dsorokin15/-/Схема/Screenshot_3.jpg

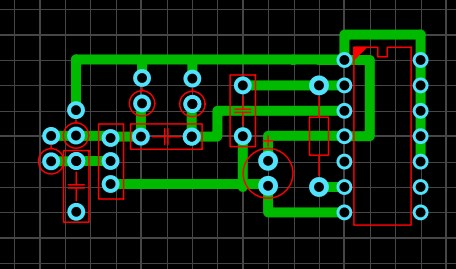
Схема/Screenshot_3.jpg
