dsorokin15/-/Схема/s43343011.jpg

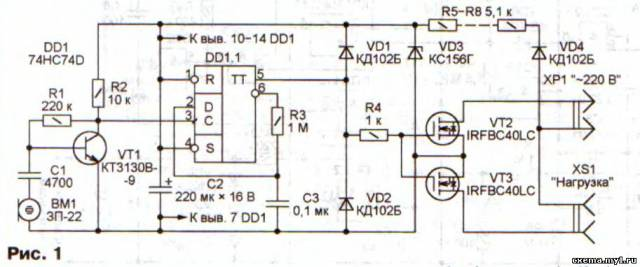
Схема/s43343011.jpg
