dsorokin15/-/КурсоваяСорокинДК51.docx

НАЦІОНАЛЬНИЙ ТЕХНІЧНИЙ УНІВЕРСИТЕТ УКРАЇНИ

«КИЇВСЬКИЙ ПОЛІТЕХНІЧНИЙ ІНСТИТУТ ІМЕНІ ІГОРЯ СІКОРСЬКОГО»

Кафедра конструювання електронно-обчислювальної апаратури

КУРСОВА РОБОТА

з дисципліни Схемотехніка аналогової та цифрової радіоелектронної апаратури

на тему:Акустичний перемикач (АП)

Студента 2 курсу групи ДК-51

Напряму підготовки: Радіоелектронні апарати

Спеціальності: Радіоелектронні апарати та засоби

Сорокіна Д.А.

Керівник:

____________________________________

(посада, вчене звання, науковий ступінь, прізвище та ініціали)

Національна оцінка: ________________

Кількість балів: ____ Оцінка: ECTS _____

Члени комісії: _____________ ___ст. викл., к.т.н. Короткий Є.В.___

(підпис) (вчене звання, науковий ступінь, прізвище та ініціали)

_____________ _________________________________

(підпис) (вчене звання, науковий ступінь, прізвище та ініціали)

Київ − 2017 рік

ЗМІСТ

Зміст_________________________________________________________ | 2
Вступ_________________________________________________________ | 3
1. Вибір та дослідження принципової схеми АП_____________________ | 4
2. Розрахунок принципової схеми (характеристик) АП________________ | 7
3. Моделювання роботи АП______________________________________ | 11
4. Розробка та дослідження конструкції АП_________________________ | 14
Висновки______________________________________________________ | 20
Список використаних джерел _____________________________________ | 21

ВСТУП

Метою даної курсової роботи є створення акустичного вимикача, який може видавати на виході різний рівень напруги, залежно від акустичного впливу на нього. Даний прилад може бути використаний як вимикач для різноманітних приладів, а також реєстратор звукових імпульсів.

Для вирішення даної задачі для початку було обрано принципову схему [1] та досліджено принцип її роботи. Наступним кроком було проведено розрахунки підсилюючого каскаду зі спільним емітером на біполярному транзисторі. Після цього в програмі ltspice була побудована принципова схема та проведена її симуляція, що дозволило перевірити працездатність АП, а також перевірено правильність теоретичних розрахунків. Кінцевим етапом було зібрано АП на макетній платі, з нього було знято певні дані, що були порівнянні з розрахунками та симуляціею в ltspice.

РОЗДІЛ 1

ВИБІР ТА ДОСЛІДЖЕННЯ ПРИНЦИПОВОЇ СХЕМИ АКУСТИЧНОГО ПЕРЕМИКАЧА

Для основи акустичного вимикача була обрана принципова схема наведена на рис. 1.1

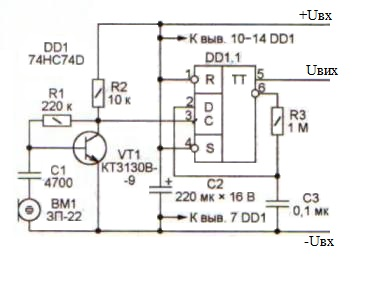
[picture p3: figure]

Рис1.1 Принципова схема акустичного перемикача

В даному випадку наведена спрощена схема, без параметричного стабілізатору напруги [1]. В даній схемі використовується мікросхема 74HC74. Вона містить два незалежних D-тригери, які спрацьовують по фронту тактового сигналу на вході С. Низький рівень напруги (логічний «0») на вході установки (S) чи збросу (R) встановлюють виходи тригера в відповідний стан незалежно від стану інших входів (С та D).

При наявності на вході установки та збросу логічної «1» необхідна попередня установка інформації по виходу даних відносно фронту тактового сигналу, а також відповідна витримка інформації після подачі фронту синхросигналу. Дані істинності наведено в табл. 1.1

Характеристики даної мікросхеми наведені в табл. 1.2. Повний список характеристик можна знайти за посиланням [2].

Таблиця 1.1

Логічна таблиця 74НС74

Входи | | | | Виходи
_ S | _ R | C | D | Q | _ Q
0 | 1 | X | X | 1 | 0
1 | 0 | X | X | 0 | 1
0 | 0 | X | X | Н | Н
1 | 1 | _| | 1 | 1 | 0
1 | 1 | _| | 0 | 0 | 1
1 | 1 | 0 | X | Qo | Qo

Таблиця 1.2

Основні параметри 74НС74

Напруга живлення (Vcc) | +2..6В
Вхідний струм (0/1), не більше | 1мкА
Струм живлення (статичний), max | 20мкА
Вихідний струм лог. "0/1", макс. | 25мА
Тактова частота | до 36МГц
Вихідний рівень "0" | < 0,1В
Вихідний рівень "1" | >Uпит-0,1В
Робочий діапазон температур | -55..+125oC
Корпус 74HC74AN Корпус 74HC74D | DIP-14 SO-14
Вітчизняний аналог | КР/КФ1564ТМ2

Принцип роботи схеми дуже простий. На вході присутній мікрофон, який реєструє зміни звуку у навколишньому середовищі. Він під’єднаний на вхід підсилюючого каскаду на транзисторі, який підсилює реєструючий звук, щоб мікросхема мала змогу його коректно сприймати. Коли на вхід С мікросхеми приходить фронт сигналу, а на вході Д присутня логічна «1», виходи мікросхеми встановлюються відповідно до логічної таблиці Q-«1», а інвертований вихід відповідно «0», який за зворотнім зв’язком подається на вхід Д. Тепер при надходженні наступного фронту на вхід С, на вході Д буде присутній логічний «0», в такому випадку на виході Q встановиться значення логічного «0». В результаті відбувається зміна рівнів напруги «перемикання».

РОЗДІЛ 2

РОЗРАХУНОК ПРИНЦИПОВОЇ СХЕМИ АКУСТИЧНОГО ПЕРЕМИКАЧА

Для попередньої перевірки працездатності схеми було проведено певні розрахунки характеристик, а саме робоча точка підсилюючого каскаду на транзисторі VT1-2N2222A [3] Рис2.1.

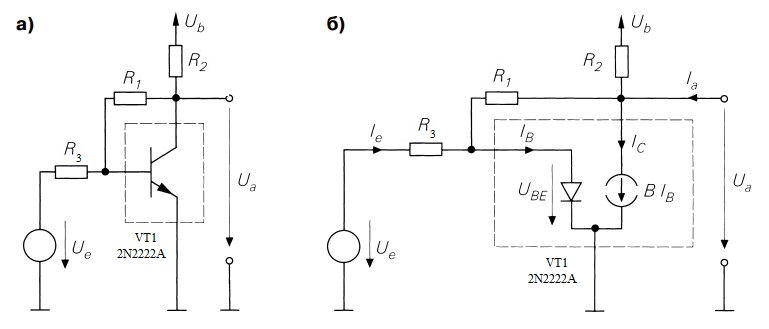
[picture p4: figure]

Рис 2.1 Схема з загальнім емітером і від’ємним зворотним зв’язком за напругою:

а) принципова схема; б) еквівалентна схема для нормального режиму [4]

Розрахунок відштовхувався від обрання напруги коллектор-емітер. Ми вирішили опиратись на значення в 1,3 В, так як це рівень напруги логічного «0» для мікросхеми 74НС74. Тому робоча точка виходу повинна знаходитись трохи нижче (нами обрано значення в 1,2 В) заданного параметру, щоб при надходжені мінімального імпульсу та підсилення D-тригер спрацьовував.

U_(R1) -напруга на резисторі R1

I_(R1) =I_б -струм через резистор R1, дорівнює струму бази

U_(R2) -напруга на резисторі R2

I_(R2) =I_к -струм через резистор R2, дорівнює струму коллектора

U_(ке) - напруга між коллектором та емітером

R1 , R2, R3-резистори номіналом 220кОм/10кОм/0.5кОм відповідно

β -коефіціент відношення струму коллеткора до струму бази

g_m ,S-передаточна провідність

А- коефіціент підсилення за напругою

γ_T -температурние коефіцієнт(26 мВ для кімнатної температури)

За 2 законом Кірхгофа напруга, яка виділиться на R2, буде розраховуватися як:

U_(R2) =U_(живлення) -U_(ке) =5-1.2=3.8 В

За законом Ома можемо знайти струм через цей резистор

I_(R2) =(U_(R2))/(R_2)=3.8/(10*10^3)=0.38 мА

За 1 законом Кірхгофа

I_(R2) = I_б +I_к

Але струм бази достатньо малий для біполярного транзистору, щоб ним можна було знехтувати, тому можна стверджувати, що I_(R2) = I_к

З документації на транзистор для отриманого значення Iк було визначена напруга Uбе, графік залежності Uбе (Iк) наведено на рис 2.1.

Для струму 0.38 А на графіку було знайденне відповідне йому значення напруги Uбе. Для прямої за температури 25⁰С значення Uбе складає 0.63В.

За 2 законом Кірхгофа можемо стверджувати, що

U_(кб) =U_(ке) -U_(бе) =1.2-0.63=0.57 В

Ця напруга буде виділятися на R1, тому за законом Ома ми можемо знайти значення струму Iб

I_б =(U_(кб))/(R_1)=0.57/(2.2*10^5)=2.59 мкА

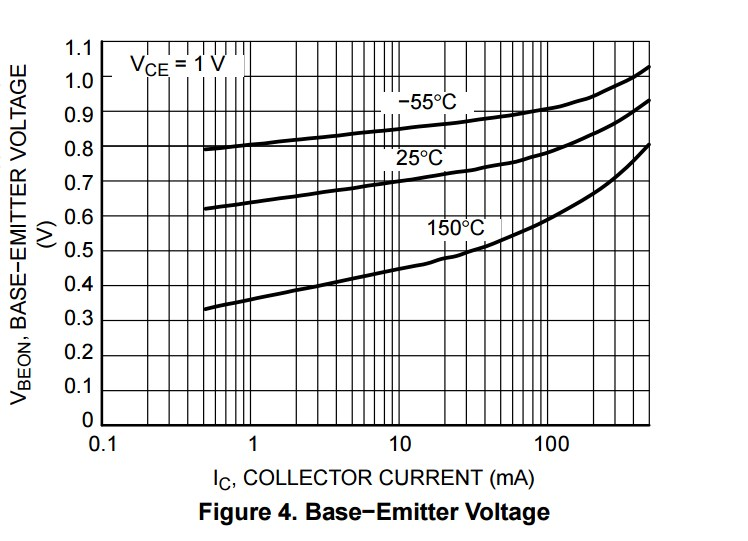
[picture p5: figure]

Рис 2.1. Вихідна характеристика транзистора

Для знайдених значень струму можна розрахувати параметр транзистору β, та передаточну провідність g_m .

β=(І_к)/(І_б)=380/2.59=146,7

g_m =(I_(k0))/(γ_T)=(0,38)/26 =14,61 мСм

Для даної схемі підключення розрахунок коефіцієнту підсилення буде проводитися за формулою (2.1) [3]

A=(-g_m *R_1 +1)/(1+R_3 *(g_m *(1+1/β)+1/(R_c^(')))+(R_1)/(R_c^('))*(1+(R_3)/(r_(be)))) (2.1)

Де

r_(be) =β/(g_m)=(146,7)/(0,01461)≈10 кОм

R_c^(') =(R_2 *r_(ce))/(R_2 +r_(ce))

Вважаючи, що опір переходу коллектор-емітер (rce) буде дуже великим, це випливає з теорії роботи транзистора, можна стверджувати, що опір паралельного з’єднання з R2 буде рівним номіналу R2, а саме 10 кОм.

Тепер можна провести розрахунок

A=(-0,0146*220000+1)/(1+500*(0,0146*(1+1/(146,7))+1/10000)+220000/10000*(1+500/10000))= -54,46

РОЗДІЛ 3

МОДЕЛЮВАННЯ РОБОТИ АКУСТИЧНОГО ПЕРЕМИКАЧА

Для перевірки працездатності принципової схеми було проведено симулювання в програмі LTspice. Для цього було побудовано схему, наведену на рис. 3.1

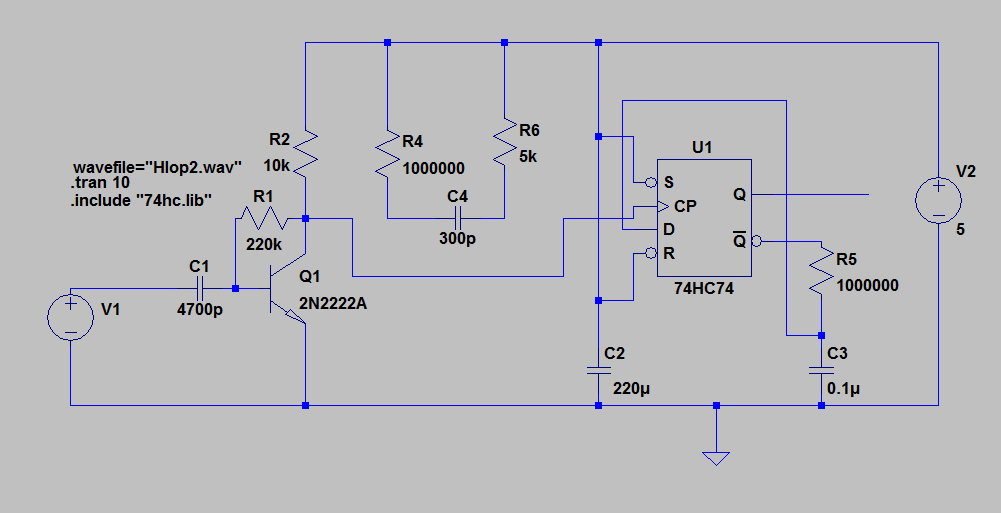
[picture p6: figure]

Рис. 3.1 Схема для симуляції

В даному випадку були внесені певні зміни до конструкції. Практична тестова модель показала, що схема занадто чутлива то зовнішніх збуджувачів, тому було прийняте рішення додати схему для боротьби з дрібяжінням сигналу [5]. Дане рішення суцільно практичне і в симуляції враховане не було. З підключенням цієї схеми симуляція припиняла свою роботу. Це пов'язано с тим, що записаний аудіофайл хлопків сприймався інакше, ніж реальний звук. Результат симуляції наведено на рис 3.2

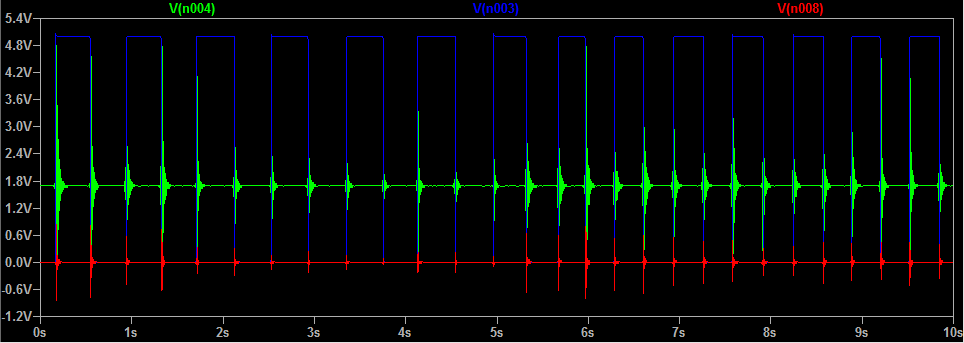
[picture p7: figure]

Рис 3.2 Симуляція роботи спроектованої принципової схеми

На симуляції ми бачимо три графіки:

1. Червоний − напруга, яка подається з джерела. В даному випадку це записаний звук хлопків.
2. Зелений − напруга на колекторі транзистору, який виконує роль підсилюючого каскаду зі спільним емітером.
3. Синій − напруга на виході мікросхеми.

Як бачимо, кожний новій імпульс спочатку підсилюється, щоб сприйматися мікросхемою. Остання в свою чергу реагує на підсилені імпульси та спрацьовує. Як результат на виході мікросхеми відбувається зміна рівнів напруги від 0 В низького рівня (логічний «0») до 5 В високого рівня (логічної «1»). Перевірка розрахованих характеристик. Напруга та струм бази відображено на рис. 3.3

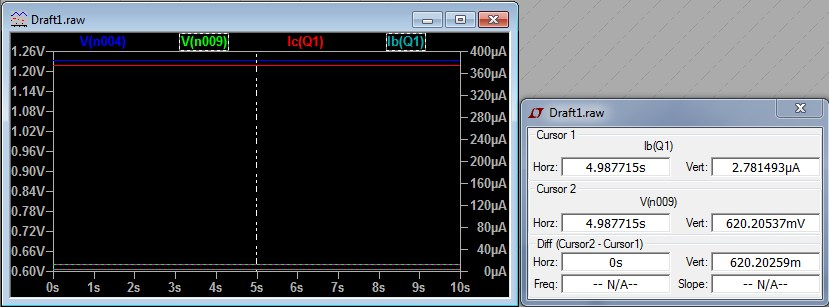
[picture p8: figure]

Рис 3.3 Напруга та струм бази

Напруга та струм колектора показано на рис 3.4

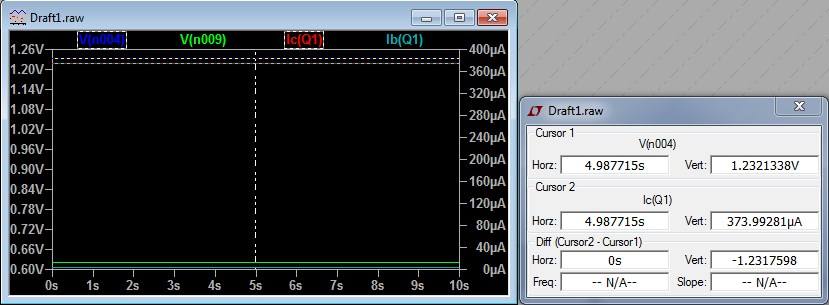
[picture p9: figure]

Рис 3.4 Напруга та струм колектора

Підсилення сигналу показано на рис 3.5

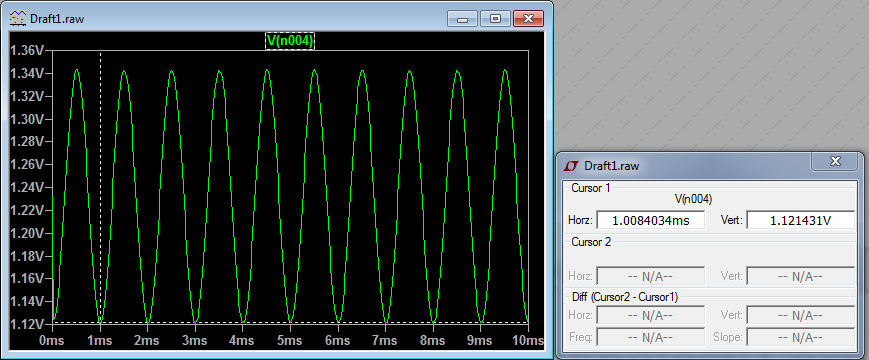
[picture p10: figure]
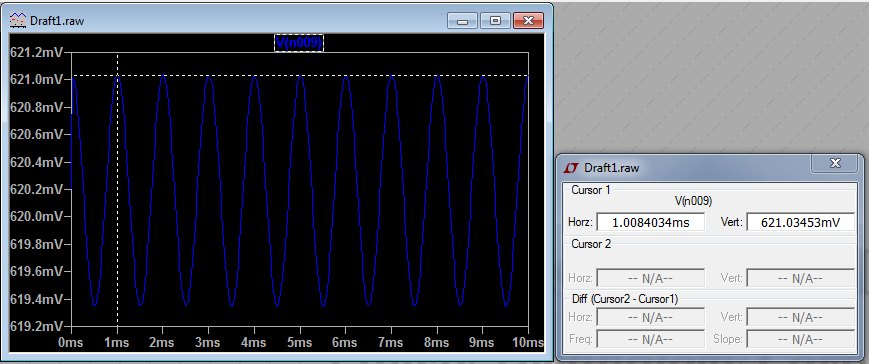
[picture p11: figure]

Рис 3.4 Підсилений сигнал

Коефіціент підсилення за напругою складає 2.

РОЗДІЛ 4

РОЗРОБКА ТА ДОСЛІДЖЕННЯ КОНТРУКЦІЇ АКУСТИЧОГО ПЕРЕМИКАЧА

Щоб упевнития в коректній роботі пристрою спочатку була зібрана тестова модель на макетній платі (див. рис 4.1)

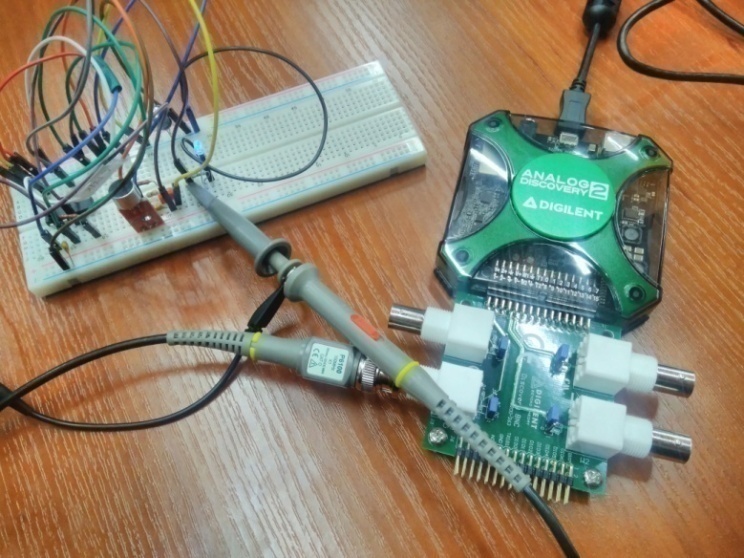
[picture p12: figure]
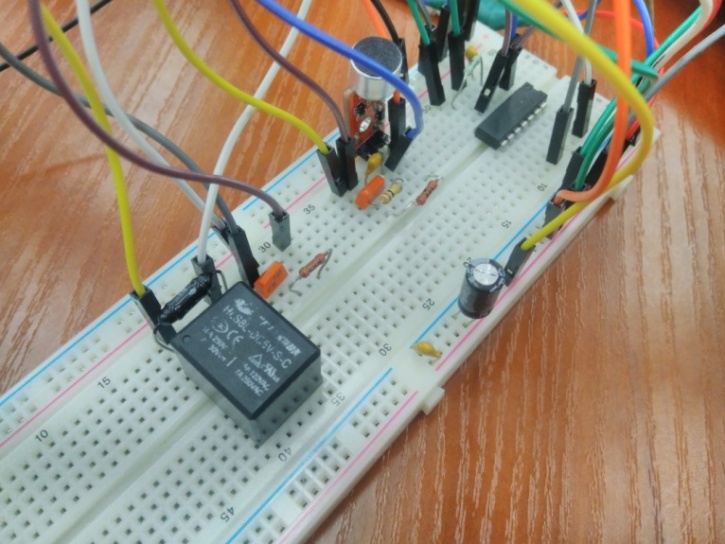
[picture p13: figure]

Рис 4.1 Тестова модель пристрою

Вона показала, що пристрій занадто чутливий. Це було підтверджено за допомогою AnalogDiscovery, знімаючи рівень напруги на вході С D-тригеру (рис 4.2)

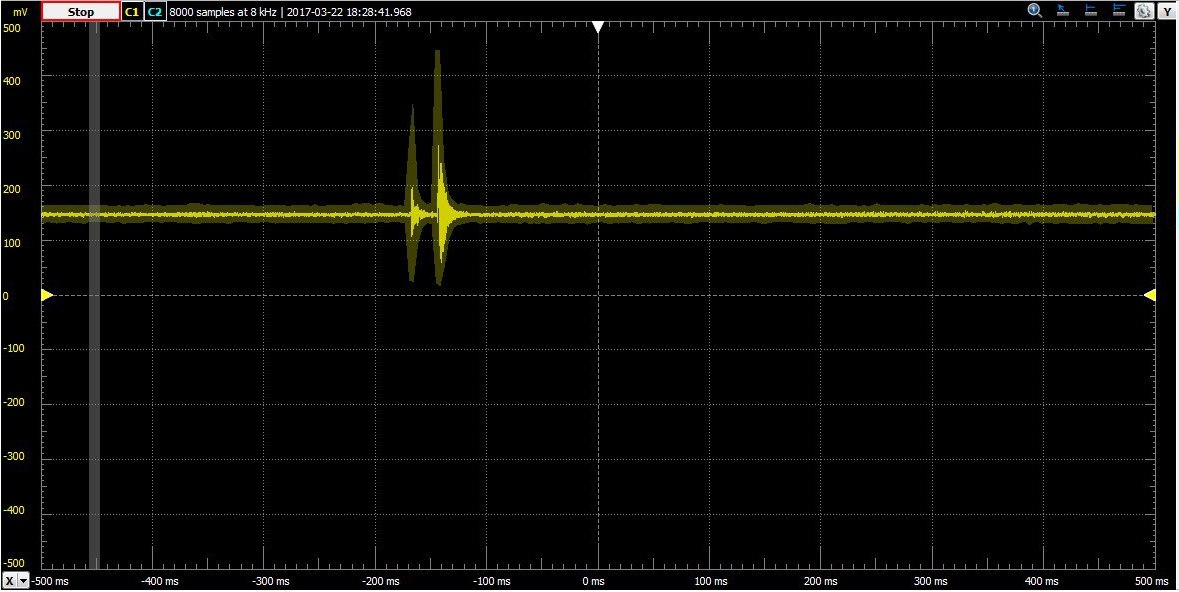
[picture p14: figure]

Рис 4.2 Показники осцилографа з тестовою моделью за допомогою AnalogDiscovery

Так були виялені різкі не однократні перепади сигналу, які призводили до хибних спрацьовувань тригеру. Ця проблема була вирішена за допомогою схеми для боротьби з дріб'яжінням від контактів, яка наведена на рис 4.3.

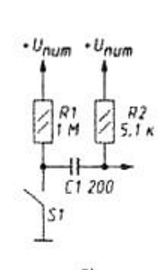
[picture p15: figure]

Рис 4.3 Схема для формування короткого імпульсу

Наступним кроком стало перенесення вже справно працюючого приладу на макетну плату. Для цього у сервісі Sprint Layout було розведено дану схему рис 4.4.


Рис 4.4 Розводка схеми

Після цього на основі побудови було зібрано та спаяно пристрій на макетній платі рис 4.5

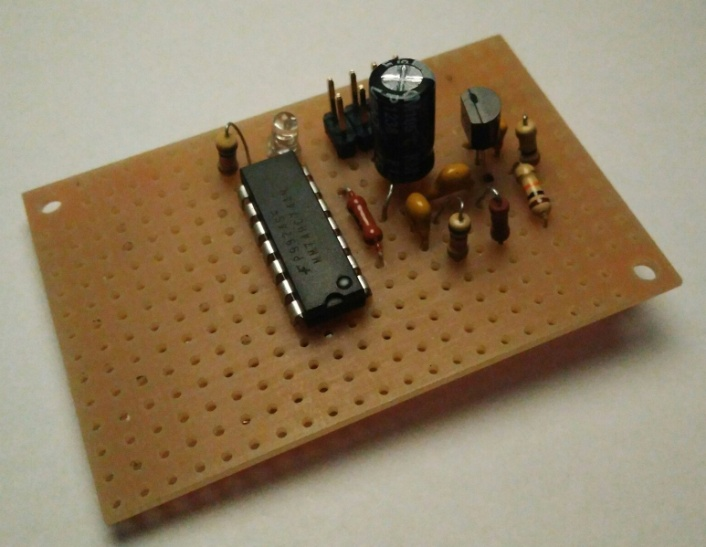
[picture p16: figure]
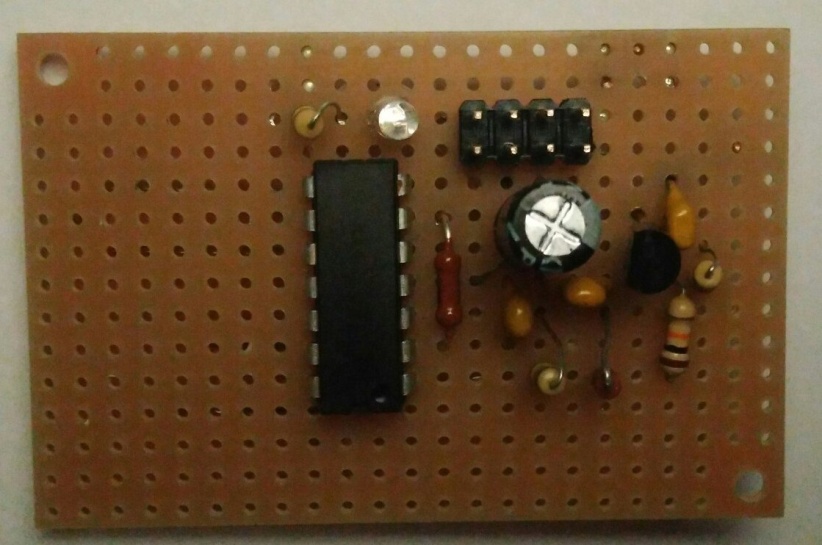
[picture p17: figure]

Рис 4.5 Зібраний прилад на макетній платі

На даному етапі ще не приєднано мікрофон, та було додано світло діод. Це необхідно для зручності проведення подальших тестів з пристроєм. Після необхідних перевірок було додано блок живлення для мережі 220В, та реле, для керування мережею 220В рис 4.6.

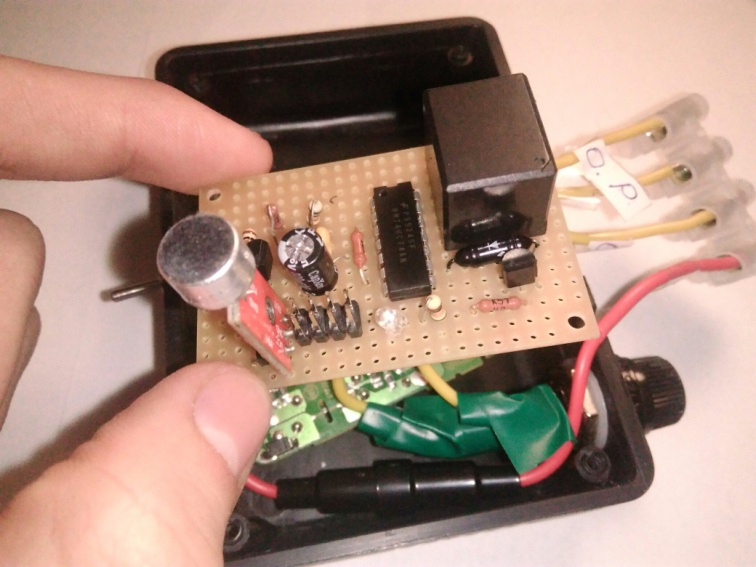
[picture p18: figure]
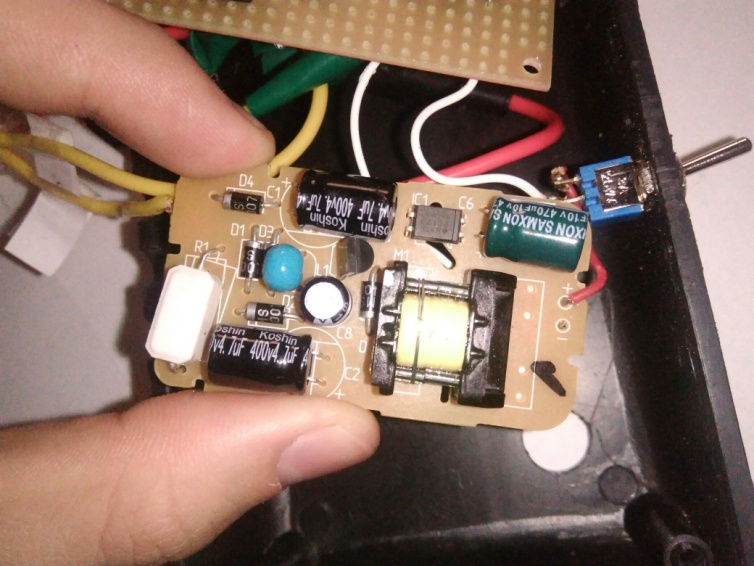
[picture p19: figure]

Рис 4.6 Реле та блок живлення для роботи з мережею 220 В

Останнім кроком в конструкції робочого прототипу стало приєднання запобіжників з метою захисту пристрою від неочікуваних перепадів струму (див. рис 4.7)

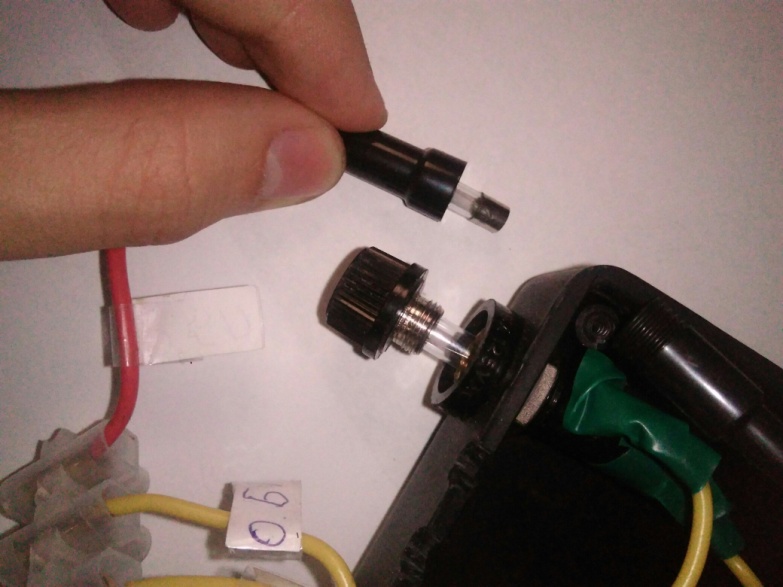
[picture p20: figure]

Рис 4.7 Запобіжники для реле та БЖ

Результатом роботи було отримано акустичний перемикач, що живиться від мережі та здатен виконувати роль вимикача, що контролюється імпульсами звуку. Рис 4.8

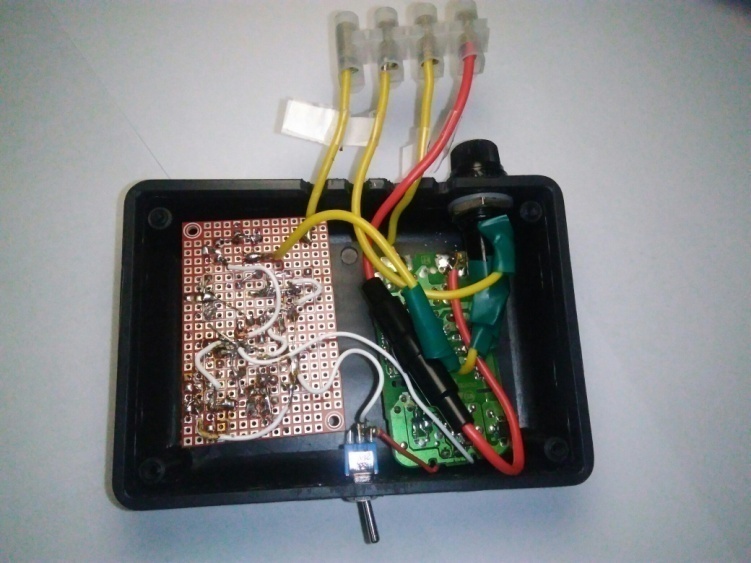
[picture p21: figure]
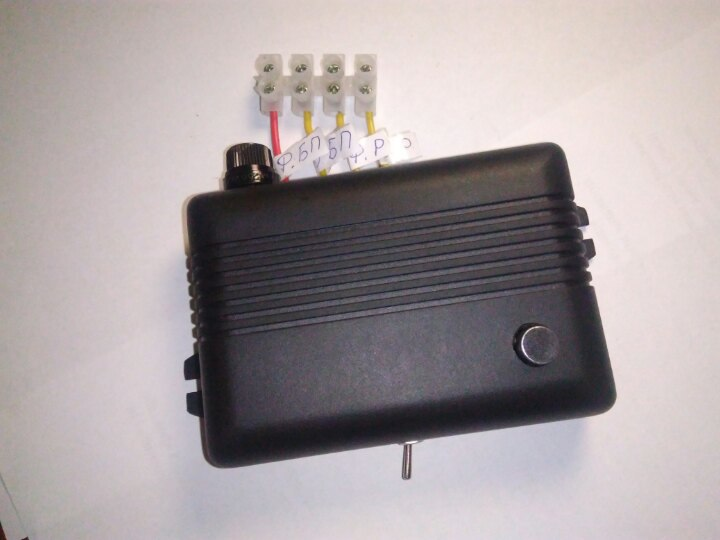
[picture p22: figure]

Рис 4.8 Остаточний вигляд пристрою з середини та зовні

Також було проведено певні виміри для перевірки розрахунків з розділу 2.

Напруга бази та колектора (див. рис 4.9)

Ube=0.601В

Uke=1.17В

Покази амперметру становлять Ib=2uA

Ik=0.39мА

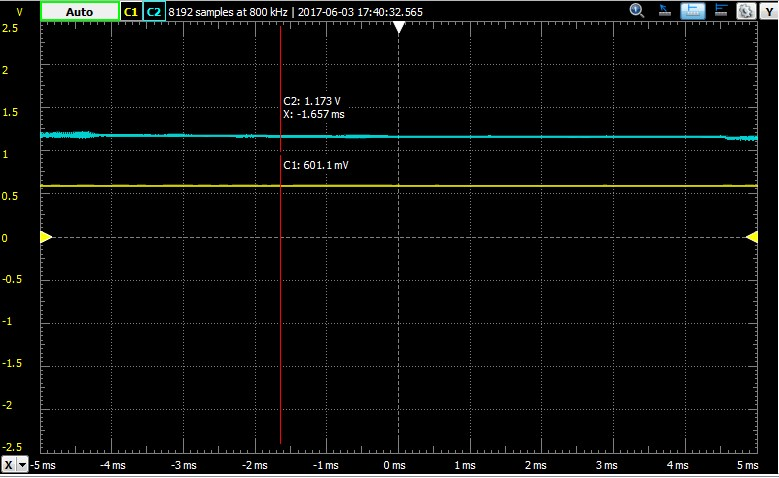
[picture p23: figure]

Рис 4.9 Напруга бази та колектора (робоча точка)

Підсилення сигналу можна спостерігати на рис 4.10

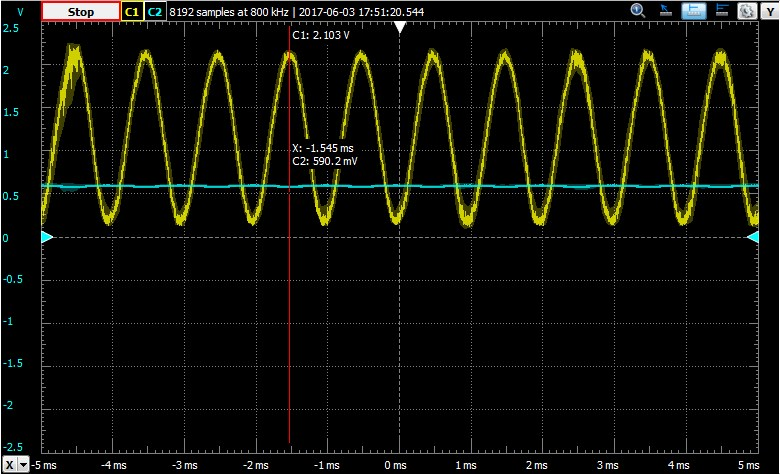
[picture p24: figure]

Рис 4.10 Підсилення сигналу каскадом

Коефіціент підсилення складає 3,56

Порівняльна характеристика основних величин наведена в табл. 4.1.

Таблиця 4.1

Параметр | Теоретичний розрахунок | Результати симуляції | Практичні виміри
Ik,мА | 0,38 | 0,37 | 0,39
Ib,мкА | 2,59 | 2,78 | 2
Ube,В | 0,63 | 0,62 | 0,6
Uke,В | 1,2 | 1,23 | 1,17
A | 54,46 | 2 | 3,56

Аналіз даних показав, що відмінність між параметрами струмів та напруг може бути спричинена округленням розрахунків, розбіжностями між теоретичними розрахунками при симуляції та реальними номінальними значеннями радіоелементів пристрою. Варто зазначити, що при виробництві біполярних транзисторів характеристики моделі варіюються в достатньо великих межах, а також в прототипі пристрою в якості резистору R1 було використано резистор номіналом 200 кОм замість допущених 220 кОм. Тому, як для напруг та струмів, так і для коефіцієнту підсилення таке відхилення буде нормальним.

Щодо відмінностей коефіцієнтів А: А теоретичний було розраховано за формулою (2.1) відповідно до [4, с.134]. Навіть при певній варіації з параметрам Uke, який був обраний довільно, та розрахунку конкретного значення для rce значення варіюювалося на ±5.

ВИСНОВКИ

В даній курсовій роботі була обрана схема акустичного перемикача. Було проведено її аналіз та досліджено принцип його роботи.

Далі були проведені теоретичні розрахунки підсилюючого каскаду на транзисторі з загальним емітером та зворотним від’ємним зв’язком за напругою, щоб перевірити працездатність запропонованої схеми. За результатами обрахунку була визначена робоча точка підсилюючого каскаду на біполярному транзисторі, та визначено коефіцієнт підсилення за напругою, його значення склало 54.

В середовищі LtSpice було проведено симуляцію для обраної схеми. Вона підтвердила попередні розрахунки та працездатність схеми, про свідчать графіки вихідних сигналів, а саме виходу Д-тригера. Здійснювалось перемикання рівнів напруги, яке лежить в основі даного пристрою. На даному етапі виникла лише одна відмінність. Значення коефіцієнт підсилення за напругою для симуляції склало приблизно 2, коли розрахункове значення значно більше.

Останнім кроком було безпосереднє проектування та збір прототипу на макетній платі. Для цього схема спочатку була розведена, а після розміщення усіх компонентів, спаяна. Зібрана модель працювала коректно та виконувала ввімкнення/вимкнення світлодіоду в результаті реакції на звукові імпульси. Для зібраного прототипу були виміряні параметри для порівняння з даними, отриманими при симуляції та розрахованими теоретично. Коефіціент підсилення за напругою для прототипу склав 3,56.

Результати показів для розрахунку, симуляції та практичного виміру знаходяться у межах норми, за виключенням коефіцієнту підсилення за напругою розраховано теоретично.

За власною ініціативою до працюючого пристрою було додано блок живлення та зібрано просту схему з використанням реле. Це було зроблено з метою використання даного пристрою для роботи в мережі 220В.

СПИСОК ВИКОРИСТАНИХ ДЖЕРЕЛ

1. Акустический выключатель [Електронний ресурс] – Режим доступу http://cxema.my1.ru/publ/razdel_skhem_dlja_nachinajushhikh_radioljubitelej/konstrukcii_prostoj_slozhnosti/akusticheskij_vykljuchatel_7/23-1-0-2958 − Назва з екрану

2. Документація на мікросхему 74НС74 [Електронний ресурс] – Режим доступу http://assets.nexperia.com/documents/data-sheet/74HC_HCT74.pdf − Назва з екрану

3. Документація на транзистор 2N2222A [Електронний ресурс] – Режим доступу http://web.mit.edu/6.101/www/reference/2N2222A.pdf − Назва з екрану

4. Титце У., Шенк К. Полупроводниковая схемотехніка, [Електронний ресурс] – Режим доступу: http://www.tverhtk.ru/library/predmets/pc_systems/Poluprovodnikovaja_shemotehnika_Tom1_2008.pdf – Назва з екрану

5. Формирование и генераторы импульсов [Електронний ресурс] – Режим доступу: http://www.junradio.com/nach/TTL/CHAPTER3/3.htm − Назва з екрану
