dsorokin15/-/Макетна плата/ib2WyIDGSO8.jpg

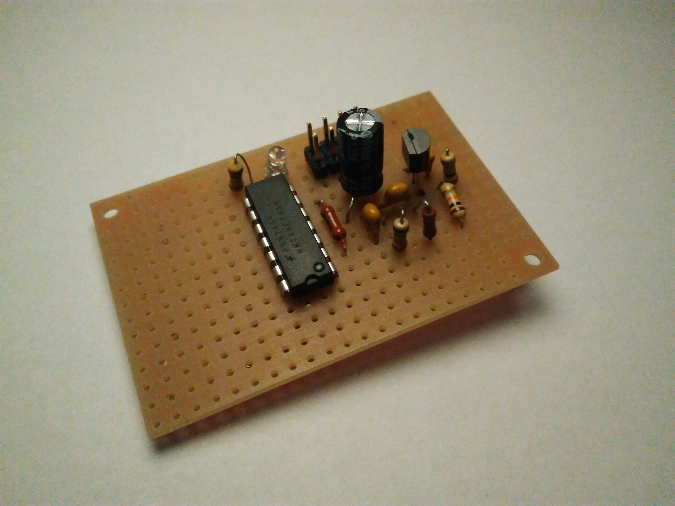
Макетна плата/ib2WyIDGSO8.jpg
