dsorokin15/-/Макетна плата/IMG_20170303_183253.jpg

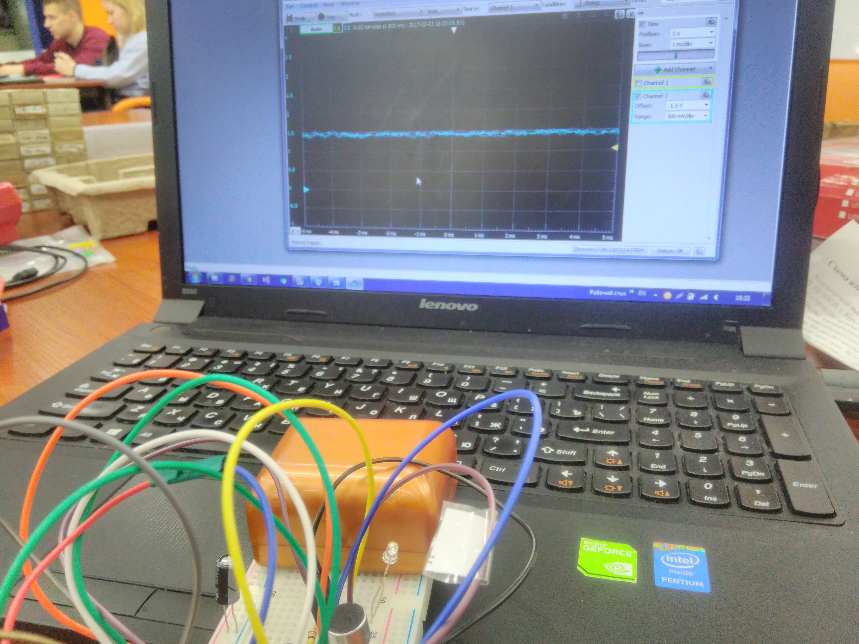
Макетна плата/IMG_20170303_183253.jpg
