dsorokin15/-/Макетна плата/WOo7wjazi40.jpg

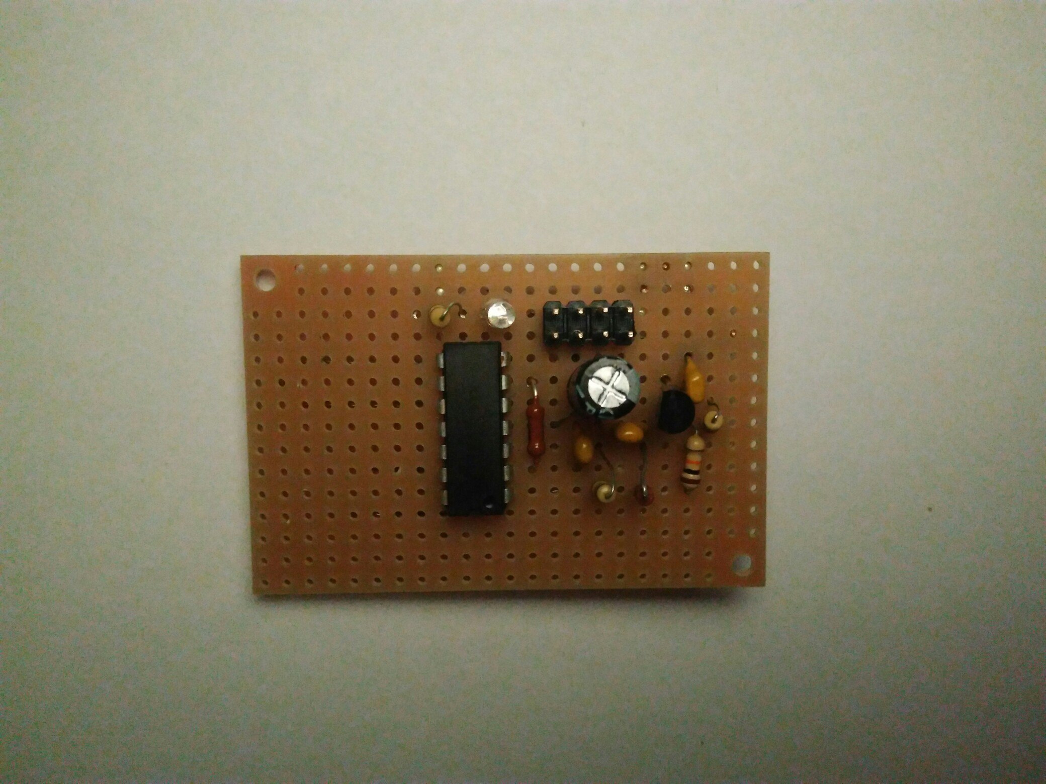
Макетна плата/WOo7wjazi40.jpg
