dsorokin15/-/Моделювання/Screenshot_2.jpg

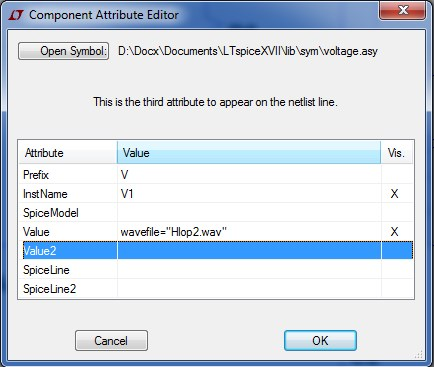
Моделювання/Screenshot_2.jpg
