dsorokin15/-/Осцилограмми/Ku2.jpg

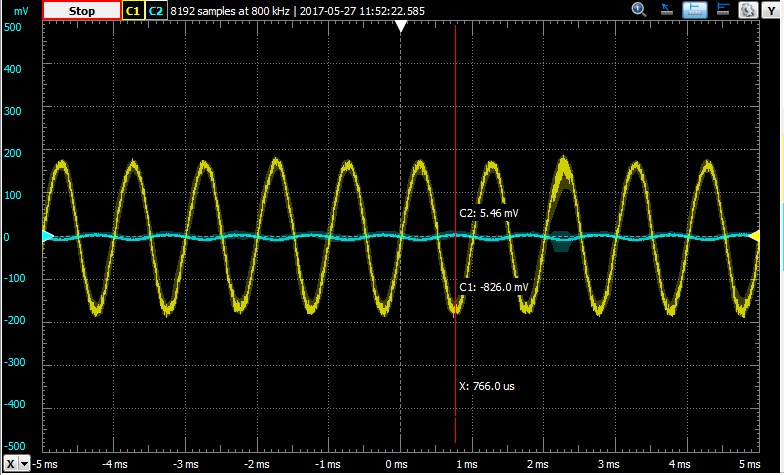
Осцилограмми/Ku2.jpg
