dsorokin15/-/Осцилограмми/KU.jpg

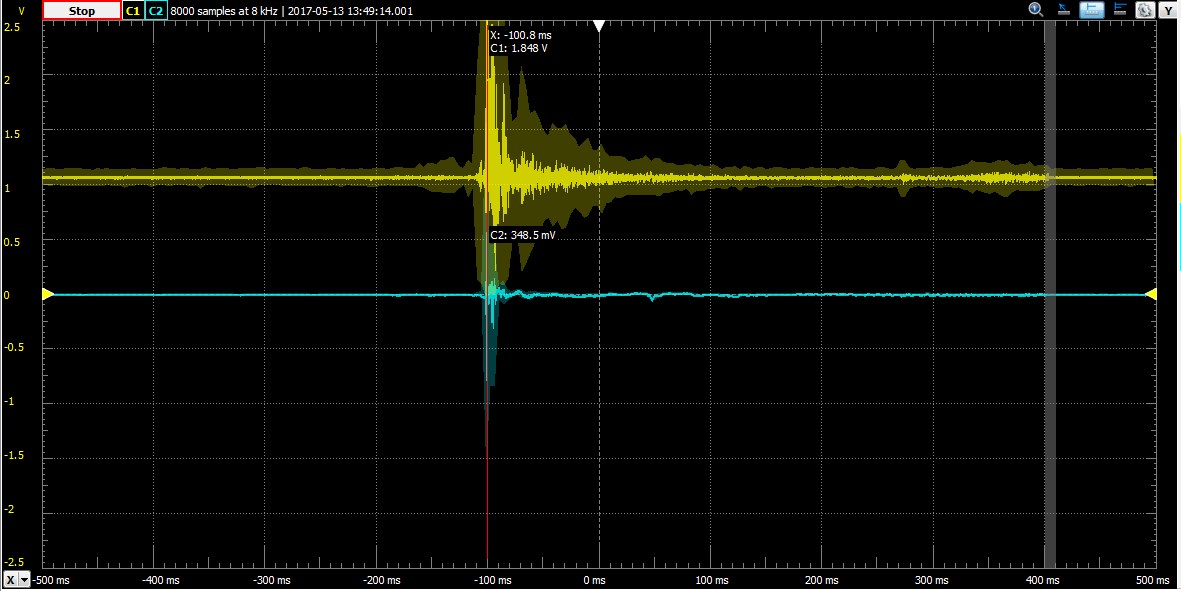
Осцилограмми/KU.jpg
