dsorokin15/-/Осцилограмми/Завади.jpg

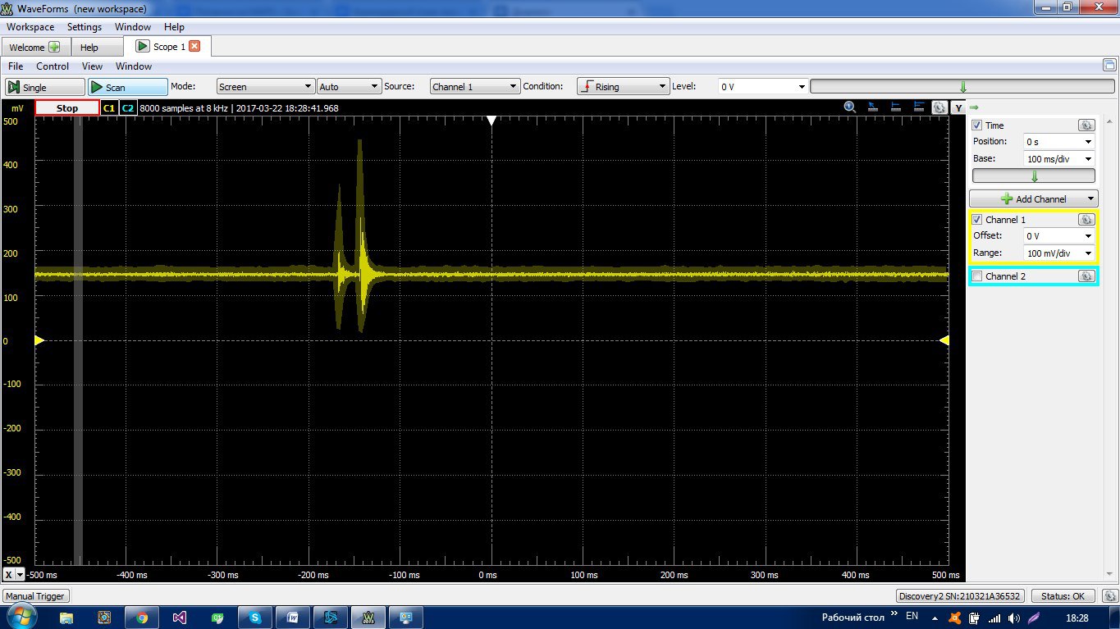
Осцилограмми/Завади.jpg
