dsorokin15/-/Осцилограмми/Ку2.jpg

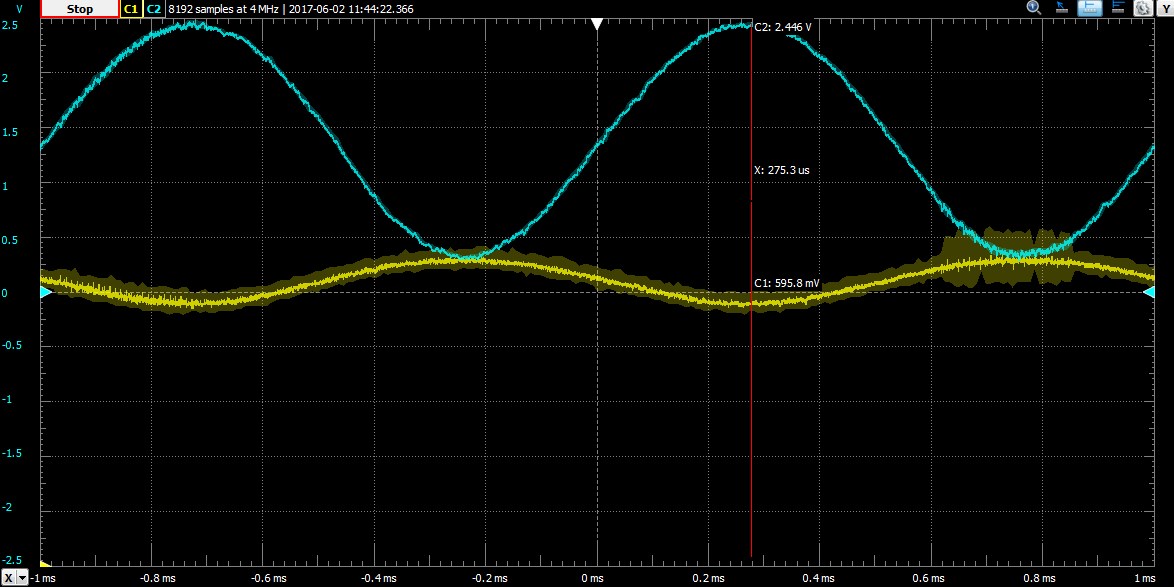
Осцилограмми/Ку2.jpg
