dsorokin15/-/Осцилограмми/Робоча точка .jpg

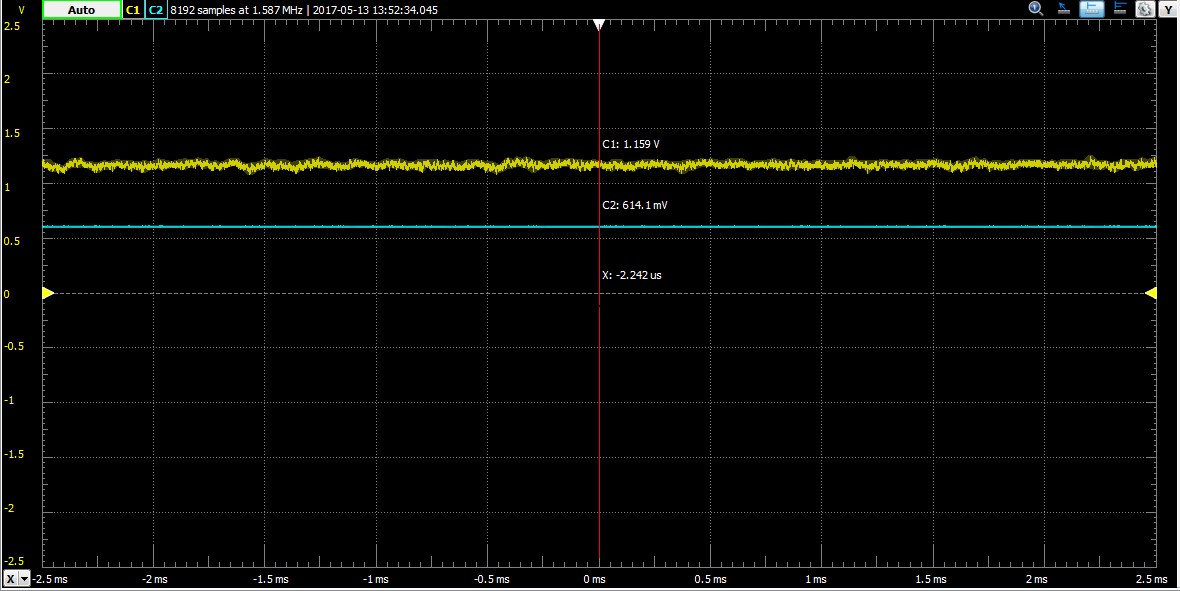
Осцилограмми/Робоча точка .jpg
