dsorokin15/-/Пристрій/7S2vs7nZZ24.jpg

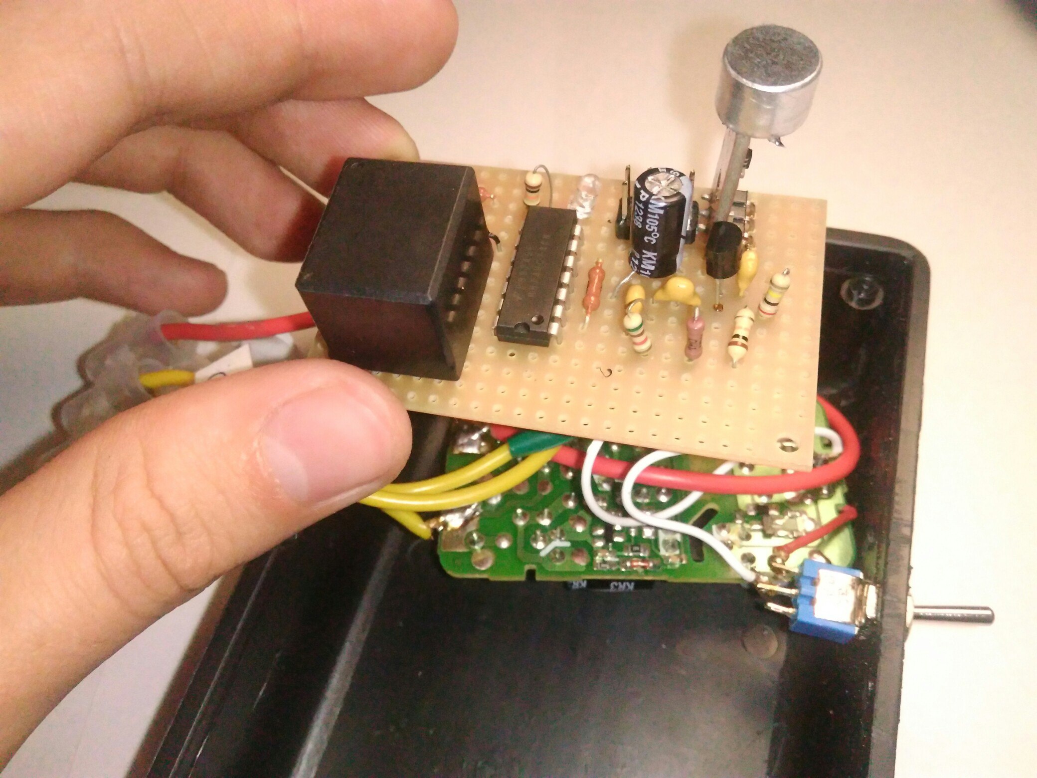
Пристрій/7S2vs7nZZ24.jpg
