dsorokin15/-/Пристрій/fz7AS3TFOkQ.jpg

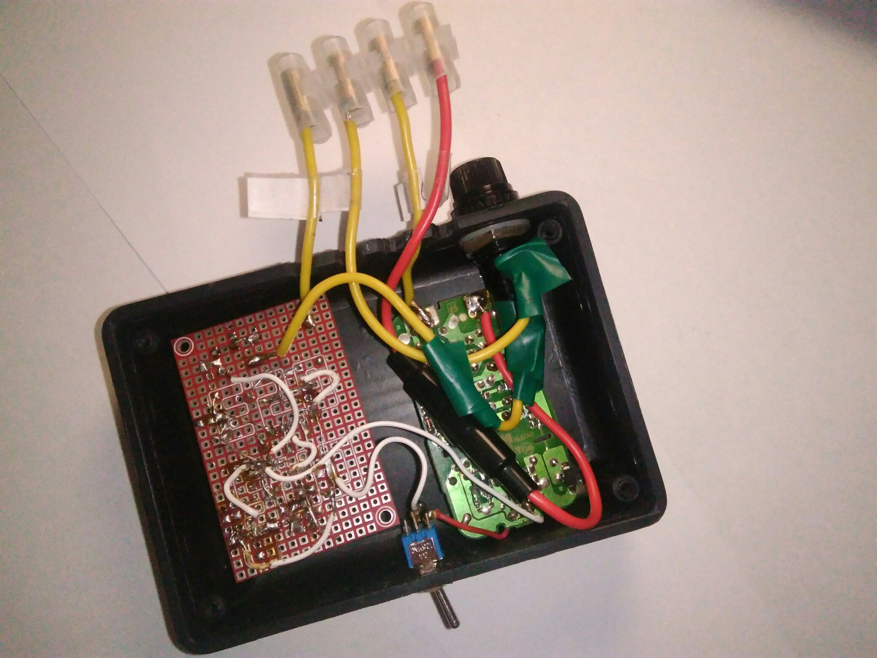
Пристрій/fz7AS3TFOkQ.jpg
