dsorokin15/-/Пристрій/LxV6hZRfm6E.jpg

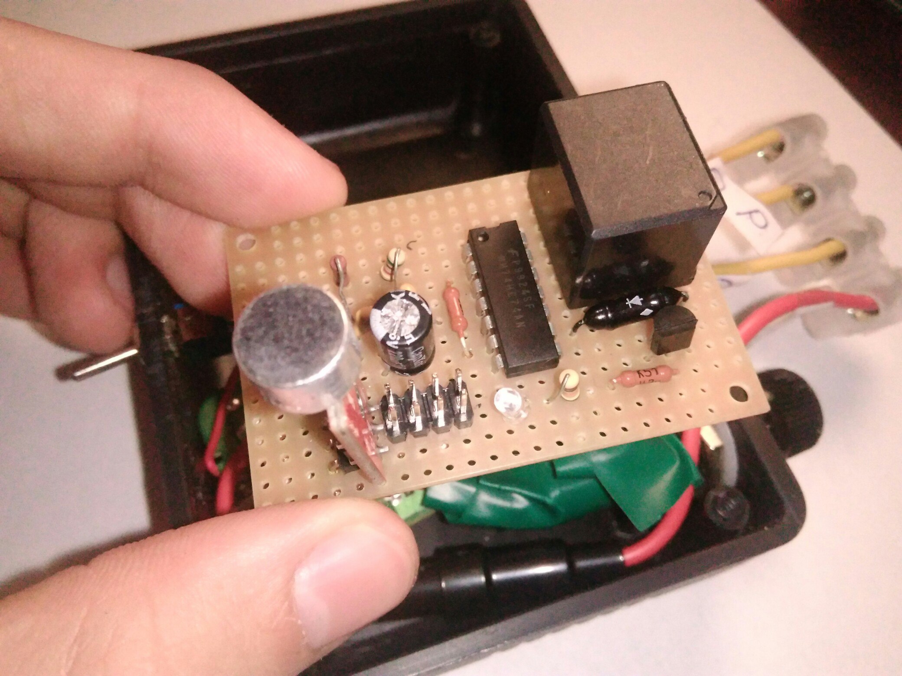
Пристрій/LxV6hZRfm6E.jpg
