dsorokin15/-/Пристрій/TOmwGJkglKo.jpg

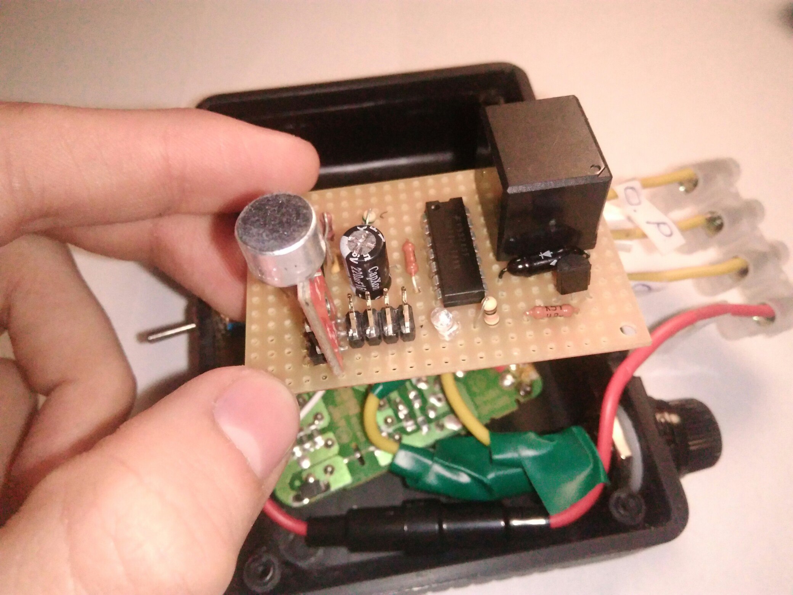
Пристрій/TOmwGJkglKo.jpg
