dsorokin15/-/Схема/ewwwe.jpg

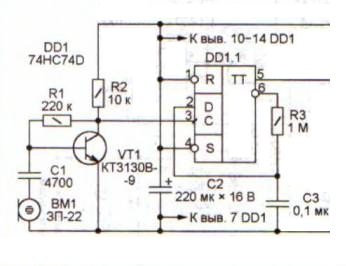
Схема/ewwwe.jpg
