dsorokin15/-/Схема/Screenshot_2.jpg

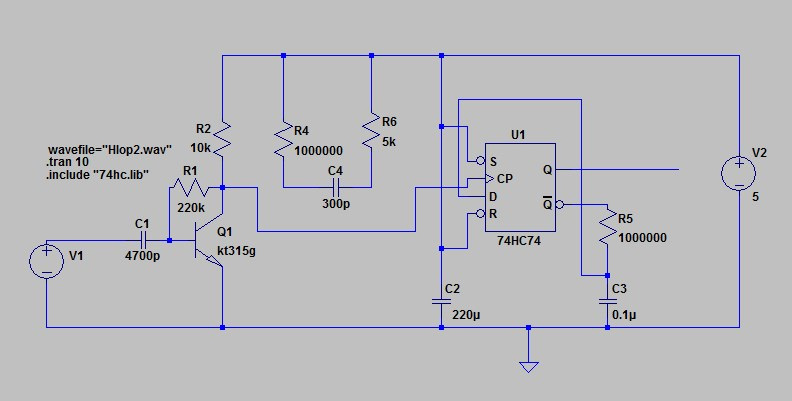
Схема/Screenshot_2.jpg
