dsorokin15/-/Схема/Screenshot_4.jpg

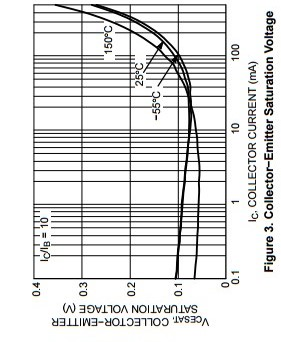
Схема/Screenshot_4.jpg
