dsorokin15/-/Схема/Screenshot_6.jpg

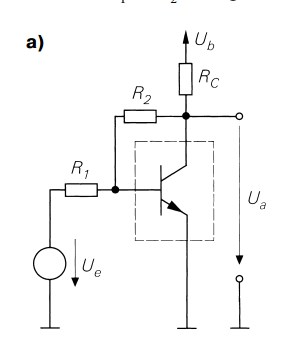
Схема/Screenshot_6.jpg
