dsorokin15/-/Схема/Screenshot_9.jpg

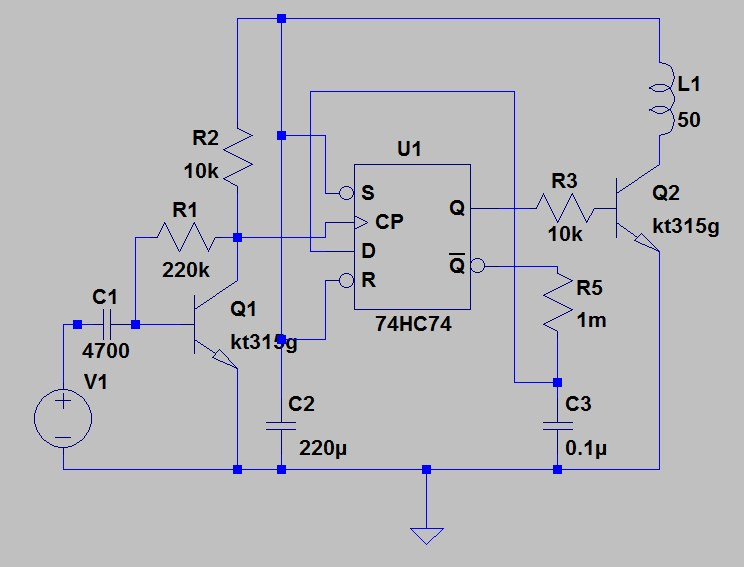
Схема/Screenshot_9.jpg
