dsorokin15/-/Моделювання/Draft1.asc

C1: cap; 4700
C2: cap; 220µ
C3: cap; 0.1µ
L1: ind; 50
Q1: npn; kt315g
Q2: npn; kt315g
R1: res; 220k
R2: res; 10k
R3: res; 10k
R5: res; 1m
U1: 74hc74.1
V1: voltage; wavefile=Hlop3.wav
Named nets: 0
.tran 60
.include "74hc.lib"
